SanabriaRusso/OSN/Thesis/Notes/Document_Structure.md

# Estructura

##
* I - Title
* II - Declaration
* III - Acknowledgements
* IV - Abstract
* V - Table of Contents
##

##
* 1 - Introduction
* 2 - State of the Art
    * Otras alternativas, qué se ha hecho hasta el momento, etc.
##

##
* 3 - Materials, Protocols and Platform
    * Descripción de Arduino, XBee, sensores utilizados, etc.
* 3.5 - Methodology
* 4 - The Network
    * Estructura, código...
* 5 - Results and Discussion
##

##
* 6 - Conclussions and possible further work
* 7 - References
* 8 - Appendices
##
