SanabriaRusso/OSN/Thesis/main.tex

%%%%%%%%%%%%%%%%%%%%%%%%%%%%%%%%%%%%%%%%%
% Thesis 
% LaTeX Template
% Version 1.3 (21/12/12)
%
% This template has been downloaded from:
% http://www.latextemplates.com
%
% Original authors:
% Steven Gunn 
% http://users.ecs.soton.ac.uk/srg/softwaretools/document/templates/
% and
% Sunil Patel
% http://www.sunilpatel.co.uk/thesis-template/
%
% License:
% CC BY-NC-SA 3.0 (http://creativecommons.org/licenses/by-nc-sa/3.0/)
%
% Note:
% Make sure to edit document variables in the Thesis.cls file
%
%%%%%%%%%%%%%%%%%%%%%%%%%%%%%%%%%%%%%%%%%

%----------------------------------------------------------------------------------------
%	PACKAGES AND OTHER DOCUMENT CONFIGURATIONS
%----------------------------------------------------------------------------------------

\documentclass[11pt, a4paper, oneside]{Thesis} % Paper size, default font size and one-sided paper

\graphicspath{{./Pictures/}} % Specifies the directory where pictures are stored

\usepackage{pdfpages}
\usepackage{titlesec}
\setcounter{secnumdepth}{4}

\usepackage[utf8]{inputenc}
\usepackage[square, numbers, comma, sort&compress]{natbib}
\usepackage{verbatim} 
%\usepackage{footnote}
\hypersetup{urlcolor=blue, colorlinks=true} % Colors hyperlinks in blue - change to black if annoying
\title{\ttitle} % Defines the thesis title - don't touch this

\begin{document}

\frontmatter % Use roman page numbering style (i, ii, iii, iv...) for the pre-content pages

\setstretch{1.3} % Line spacing of 1.3

% Define the page headers using the FancyHdr package and set up for one-sided printing
\fancyhead{} % Clears all page headers and footers
\rhead{\thepage} % Sets the right side header to show the page number
\lhead{} % Clears the left side page header

\pagestyle{fancy} % Finally, use the "fancy" page style to implement the FancyHdr headers

\newcommand{\HRule}{\rule{\linewidth}{0.5mm}} % New command to make the lines in the title page

% PDF meta-data
\hypersetup{pdftitle={\ttitle}}
\hypersetup{pdfsubject=\subjectname}
\hypersetup{pdfauthor=\authornames}
\hypersetup{pdfkeywords=\keywordnames}

%----------------------------------------------------------------------------------------
%	TITLE PAGE
%----------------------------------------------------------------------------------------

\begin{titlepage}
\begin{center}

\textsc{\LARGE \univname}\\[1.5cm] % University name
\textsc{\Large Bachelor Thesis}\\[0.5cm] % Thesis type

\HRule \\[0.4cm] % Horizontal line
{\huge \bfseries \ttitle}\\[0.4cm] % Thesis title
\HRule \\[1.5cm] % Horizontal line
 
\begin{minipage}{0.4\textwidth}
\begin{flushleft} \large
\emph{Author:}\\
\href{http://alejandroandr.eu}{\authornames} % Author name - remove the \href bracket to remove the link
\end{flushleft}
\end{minipage}
\begin{minipage}{0.4\textwidth}
\begin{flushright} \large
\emph{Supervisor:} \\
\href{http://jaumebarcelo.info}{\supname} % Supervisor name - remove the \href bracket to remove the link  
\end{flushright}
\end{minipage}\\[3cm]
 
\large \textit{A thesis submitted in fulfilment of the requirements\\ for the degree of \degreename}\\[0.3cm] % University requirement text
\textit{in the}\\[0.4cm]
\groupname\\\deptname\\[2cm] % Research group name and department name
 
{\large \today}\\[4cm] % Date
%\includegraphics{Logo} % University/department logo - uncomment to place it
 
\vfill
\end{center}

\end{titlepage}

%----------------------------------------------------------------------------------------
%	DECLARATION PAGE
%	Your institution may give you a different text to place here
%----------------------------------------------------------------------------------------

\Declaration{

\addtocontents{toc}{\vspace{1em}} % Add a gap in the Contents, for aesthetics

I, \authornames, declare that this thesis titled, '\ttitle' and the work presented in it are my own. I confirm that:

\begin{itemize} 
\item[\tiny{$\blacksquare$}] This work was done wholly or mainly while in candidature for a research degree at this University.
\item[\tiny{$\blacksquare$}] Where any part of this thesis has previously been submitted for a degree or any other qualification at this University or any other institution, this has been clearly stated.
\item[\tiny{$\blacksquare$}] Where I have consulted the published work of others, this is always clearly attributed.
\item[\tiny{$\blacksquare$}] Where I have quoted from the work of others, the source is always given. With the exception of such quotations, this thesis is entirely my own work.
\item[\tiny{$\blacksquare$}] I have acknowledged all main sources of help.
\item[\tiny{$\blacksquare$}] Where the thesis is based on work done by myself jointly with others, I have made clear exactly what was done by others and what I have contributed myself.\\
\end{itemize}
 
Signed:\\
\rule[1em]{25em}{0.5pt} % This prints a line for the signature
 
Date:\\
\rule[1em]{25em}{0.5pt} % This prints a line to write the date
}

\clearpage % Start a new page

%----------------------------------------------------------------------------------------
%	QUOTATION PAGE
%----------------------------------------------------------------------------------------

\pagestyle{empty} % No headers or footers for the following pages

\null\vfill % Add some space to move the quote down the page a bit

\textit{``The years teach much which the days never knew."}

\begin{flushright}
Ralph Waldo Emerson
\end{flushright}

\vfill\vfill\vfill\vfill\vfill\vfill\null % Add some space at the bottom to position the quote just right

\clearpage % Start a new page

%----------------------------------------------------------------------------------------
%	ABSTRACT PAGE
%----------------------------------------------------------------------------------------

\addtotoc{Abstract} % Add the "Abstract" page entry to the Contents

\abstract{\addtocontents{toc}{\vspace{1em}} % Add a gap in the Contents, for aesthetics

%%%%%%%%%%%%%%%%%%%%%%%%%%%%%%
Sensor networks are increasingly being used for environmental monitoring to anticipate or react to certain events. Despite many initiatives seemingly encouraging and being based on the use of sensor networks, only a few are really open. In this thesis we design, prototype and test a wireless sensor network using open hardware and open source software. Arduino and ZigBee are the main bases for the sensor nodes, and a Raspberry Pi is used as a data sink. Gathered information is then uploaded to cloud platforms, making it available to developers which can bring new ideas to life. The proposed solution is an economical, flexible and do-it-yourself alternative to those willing to collect and share sensory data.
%%%%%%%%%%%%%%%%%%%%%%%%%%%%%%

}

\clearpage % Start a new page

%----------------------------------------------------------------------------------------
%	ACKNOWLEDGEMENTS
%----------------------------------------------------------------------------------------

\setstretch{1.3} % Reset the line-spacing to 1.3 for body text (if it has changed)

\acknowledgements{\addtocontents{toc}{\vspace{1em}} % Add a gap in the Contents, for aesthetics

Foremost, I would like to thank my project supervisor, Jaume Barceló for his patience, motivation and guidelines. His pointers always motivated me to explore unknown horizons and I ended up learning a huge amount of knowledge.

I also strongly thank the open source community, which has been as well so motivating and helpful, and never has stopped to help. Without it, I probable could never have finished my work.

Thanks to the other fellows of BuB4EU Jorge Beltrán, Nacho Justel and Fernando Gros for accompanying me in this adventure.

Finally, my sincere gratitude as well to the European Commission through the project Commons for Europe (CIP-ICT-PSP-2011-5-297191) which was the initial seed of this project.

}
\clearpage % Start a new page

%----------------------------------------------------------------------------------------
%	LIST OF CONTENTS/FIGURES/TABLES PAGES
%----------------------------------------------------------------------------------------

\pagestyle{fancy} % The page style headers have been "empty" all this time, now use the "fancy" headers as defined before to bring them back

\lhead{\emph{Contents}} % Set the left side page header to "Contents"
\tableofcontents % Write out the Table of Contents

\lhead{\emph{List of Figures}} % Set the left side page header to "List of Figures"
\listoffigures % Write out the List of Figures

\lhead{\emph{List of Tables}} % Set the left side page header to "List of Tables"
\listoftables % Write out the List of Tables

%----------------------------------------------------------------------------------------
%	ABBREVIATIONS
%----------------------------------------------------------------------------------------

\clearpage % Start a new page

\setstretch{1.5} % Set the line spacing to 1.5, this makes the following tables easier to read

\lhead{\emph{Abbreviations}} % Set the left side page header to "Abbreviations"
\listofsymbols{ll} % Include a list of Abbreviations (a table of two columns)
{
\textbf{ACK} & \textbf{A}\textbf{C}\textbf{K}nowledgement \\
\textbf{ADC} & \textbf{A}nalog to \textbf{D}igital \textbf{C}onverter \\
\textbf{BuB} & \textbf{B}ottom-\textbf{u}p \textbf{B}roadband \\
\textbf{DIO} & \textbf{D}igital \textbf{I}nput \textbf{O}utput \\
\textbf{ICT} & \textbf{I}nformation (and) \textbf{C}ommunications \textbf{T}echnology \\
\textbf{ISM} & \textbf{I}ndustrial \textbf{S}cientific and \textbf{M}edical \\
\textbf{LAN} & \textbf{L}ocal \textbf{A}rea \textbf{N}etwork \\
\textbf{LoS} & \textbf{L}ine \textbf{o}f \textbf{S}ight \\
\textbf{OS} & \textbf{O}perating \textbf{S}ystem \\
\textbf{PAN} & \textbf{P}ersonal \textbf{A}rea \textbf{N}etwork \\
\textbf{RF} & \textbf{R}adio \textbf{F}requency \\
\textbf{SoC} & \textbf{S}ystem \textbf{o}n \textbf{C}hip \\
%\textbf{Acronym} & \textbf{W}hat (it) \textbf{S}tands \textbf{F}or \\
%\textbf{Acronym} & \textbf{W}hat (it) \textbf{S}tands \textbf{F}or \\
}

%----------------------------------------------------------------------------------------
%	PHYSICAL CONSTANTS/OTHER DEFINITIONS
%----------------------------------------------------------------------------------------

\begin{comment}
\clearpage % Start a new page

\lhead{\emph{Physical Constants}} % Set the left side page header to "Physical Constants"

\listofconstants{lrcl} % Include a list of Physical Constants (a four column table)
{
Speed of Light & $c$ & $=$ & $2.997\ 924\ 58\times10^{8}\ \mbox{ms}^{-\mbox{s}}$ (exact)\\
% Constant Name & Symbol & = & Constant Value (with units) \\
}
\end{comment}

%----------------------------------------------------------------------------------------
%	SYMBOLS
%----------------------------------------------------------------------------------------

\begin{comment}
\clearpage % Start a new page

\lhead{\emph{Symbols}} % Set the left side page header to "Symbols"

\listofnomenclature{lll} % Include a list of Symbols (a three column table)
{
$a$ & distance & m \\
$P$ & power & W (Js$^{-1}$) \\
% Symbol & Name & Unit \\

& & \\ % Gap to separate the Roman symbols from the Greek

$\omega$ & angular frequency & rads$^{-1}$ \\
% Symbol & Name & Unit \\
}
\end{comment}

%----------------------------------------------------------------------------------------
%	DEDICATION
%----------------------------------------------------------------------------------------

\setstretch{1.3} % Return the line spacing back to 1.3

\pagestyle{empty} % Page style needs to be empty for this page

\dedicatory{Dedicated to my parents, who always believed in me, and who never hesitated on answering my infancy ``\emph{why does this work?'' questions.}} % Dedication text

\addtocontents{toc}{\vspace{2em}} % Add a gap in the Contents, for aesthetics

%----------------------------------------------------------------------------------------
%	THESIS CONTENT - CHAPTERS
%----------------------------------------------------------------------------------------

\mainmatter % Begin numeric (1,2,3...) page numbering

\pagestyle{fancy} % Return the page headers back to the "fancy" style

% Include the chapters of the thesis as separate files from the Chapters folder
% Uncomment the lines as you write the chapters

\input{./Chapters/Chapter1}
\input{./Chapters/Chapter2}
\input{./Chapters/Chapter3}
\input{./Chapters/Chapter4} 
\input{./Chapters/Chapter5} 
\input{./Chapters/Chapter6} 
\input{./Chapters/Chapter7} 

%----------------------------------------------------------------------------------------
%	THESIS CONTENT - APPENDICES
%----------------------------------------------------------------------------------------

\addtocontents{toc}{\vspace{2em}} % Add a gap in the Contents, for aesthetics

\appendix % Cue to tell LaTeX that the following 'chapters' are Appendices

% Include the appendices of the thesis as separate files from the Appendices folder
% Uncomment the lines as you write the Appendices

\input{./Appendices/AppendixB}
\chapter{Pilot charter}
\includepdf[pages={-}]{Appendices/project_charter.pdf}
\chapter{Initial project schedule}
\includepdf[pages={-}]{Appendices/timing.pdf}

\addtocontents{toc}{\vspace{2em}} % Add a gap in the Contents, for aesthetics

\backmatter

%----------------------------------------------------------------------------------------
%	BIBLIOGRAPHY
%----------------------------------------------------------------------------------------

\label{Bibliography}

\lhead{\emph{Bibliography}} % Change the page header to say "Bibliography"

\bibliographystyle{unsrtnat} % Use the "unsrtnat" BibTeX style for formatting the Bibliography

\bibliography{Bibliography} % The references (bibliography) information are stored in the file named "Bibliography.bib"

\end{document}
