SanabriaRusso/OSN/Code/0.2/sketch/alpha_bb.jpg

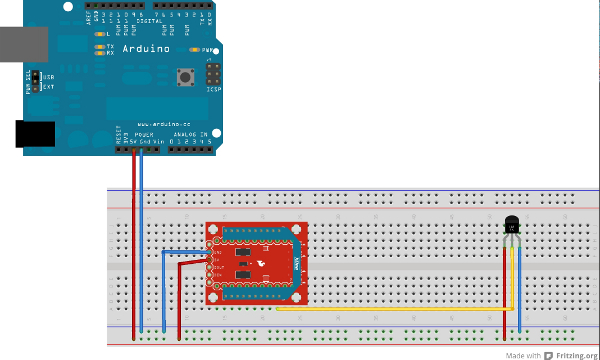
Code/0.2/sketch/alpha_bb.jpg
