SanabriaRusso/OSN/(list of files, drawings)

Other design files:
Code/0.2/sketch/alpha.fzz
old/0.2/sketch/alpha.fzz
