SanabriaRusso/OSN/(commit log)

2013-02-05 Adds new versions of the code.
    [alpha.fzz]
2013-04-18 Changes code structure.
    [alpha.fzz]
2013-04-25 Cleans code folder.
    [alpha.fzz]
2013-05-13 Updates arduino sketch.
